techgaisi-lab/esp32-sht31-homeassistant/enclosure/lid.stl

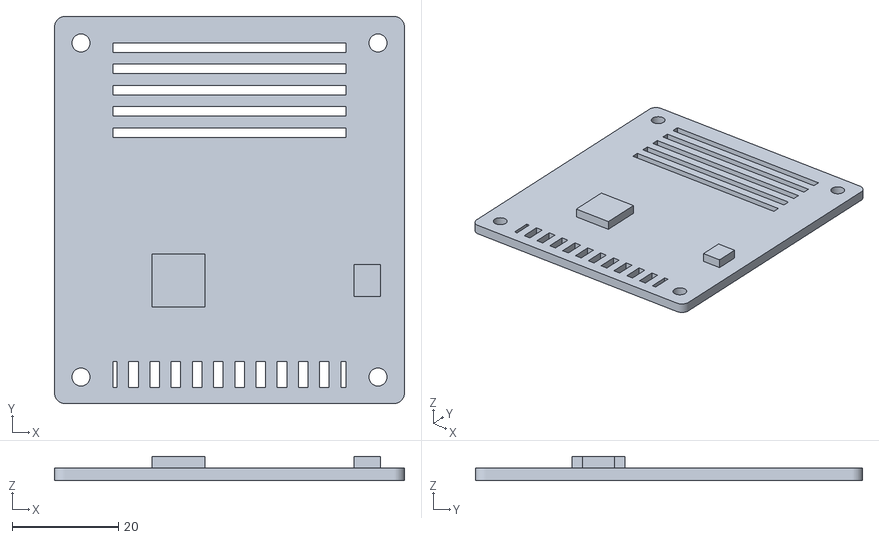
[picture p2: CAD file, 2026-11-02]
enclosure/lid.stl
66.0 x 73.0 x 4.60
