techgaisi-lab/esp32-sht31-homeassistant/enclosure/base.stl

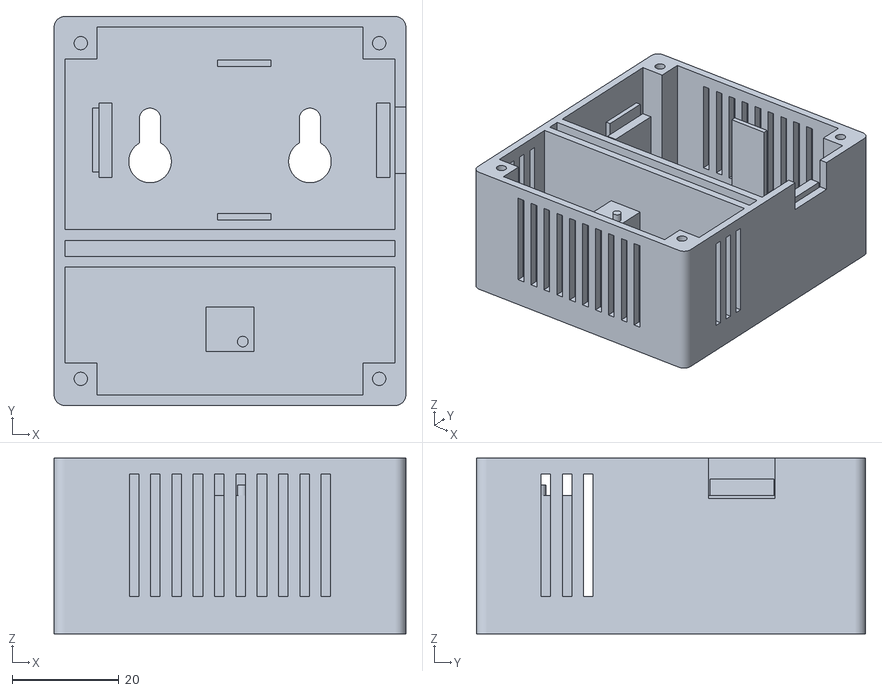
[picture p3: CAD file, 2026-11-02]
enclosure/base.stl
66.0 x 73.0 x 33.0
