techgaisi-lab/esp32-sht31-homeassistant/(commit log)

2026-11-02 Add ESPHome firmware for ESP32 + SHT31-D climate sensor
    - ESPHome config for ESP32 DevKit with SHT31-D over I²C (GPIO21/22)
    - Temperature, humidity and calculated dew point for Home Assistant
    - Encrypted API, OTA updates and fallback hotspot
    - Diagnostic entities: WiFi signal, uptime, IP address, restart button
    - Secrets template, .gitignore, MIT license and README
2026-11-02 Simplify setup: only WiFi credentials required
    - Drop API encryption key, OTA password and fallback AP password
    - Device is now added to Home Assistant with one click, no key entry
    - Reuses wifi_ssid/wifi_password already present in ESPHome secrets
    - Update README and secrets template accordingly
2026-11-02 Add 3D-printable wall-mount enclosure
    - Parametric OpenSCAD model with ready-to-print base and lid STLs
    - Separate, vented sensor chamber below the ESP32, isolated by a
    double divider wall with air gap to avoid self-heating errors
    - 24 mm clearance under the ESP32 for Dupont connectors and spare wire
    - Pegged SHT31 mount, ESP32 hold-down in lid, USB-C cutout
    - M3 screw posts and keyholes for wall mounting
    - Document print settings and assembly in README
    [base.stl, enclosure.scad, lid.stl]
