techgaisi-lab/esp32-sht31-homeassistant/(notices)

Notices in the files:
README.md:
License: MIT
